cgbriggs99/InstrumentController/README.md

# InstrumentController
Controller for an instrument panel. Interfaces with MSFS.
