cgbriggs99/InstrumentController/circuits/x27_controller_proto/x27_controller.kicad_pcb

## KiCad design circuits/x27_controller_proto/x27_controller.kicad_pcb (2024-07-07)

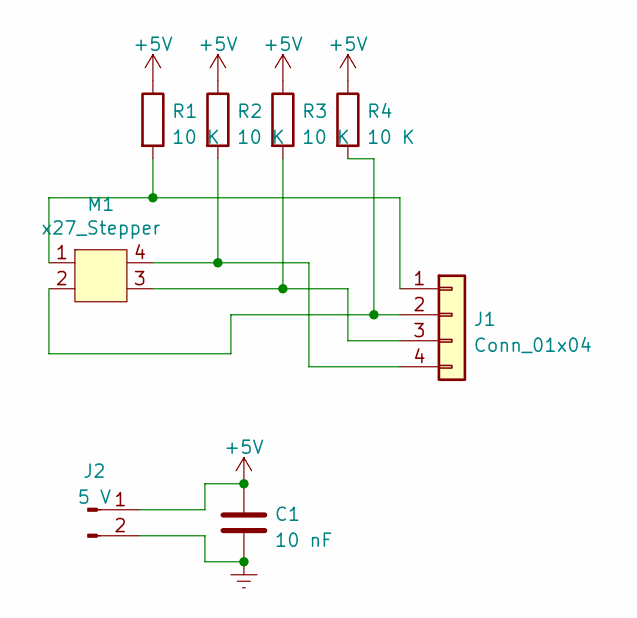
[picture p1: schematic x27_controller.kicad_sch]

Parts:
C1: 10 nF; C_0805_2012Metric_Pad1.18x1.45mm_HandSolder
J1: Conn_01x04; PinHeader_1x04_P2.54mm_Vertical
J2: 5 V; PinHeader_1x02_P2.54mm_Vertical
M1: x27_Stepper; Motor_x27-166
R1, R2, R3, R4: 10 K; R_0805_2012Metric_Pad1.20x1.40mm_HandSolder

Connections:
+5V: C1.1, J2.1, R1.1, R2.1, R3.1, R4.1
Earth: C1.2, J2.2
unnamed: J1.1, M1.1, R1.2
unnamed: J1.2, M1.2, R4.2
unnamed: J1.3, M1.3, R3.2
unnamed: J1.4, M1.4, R2.2

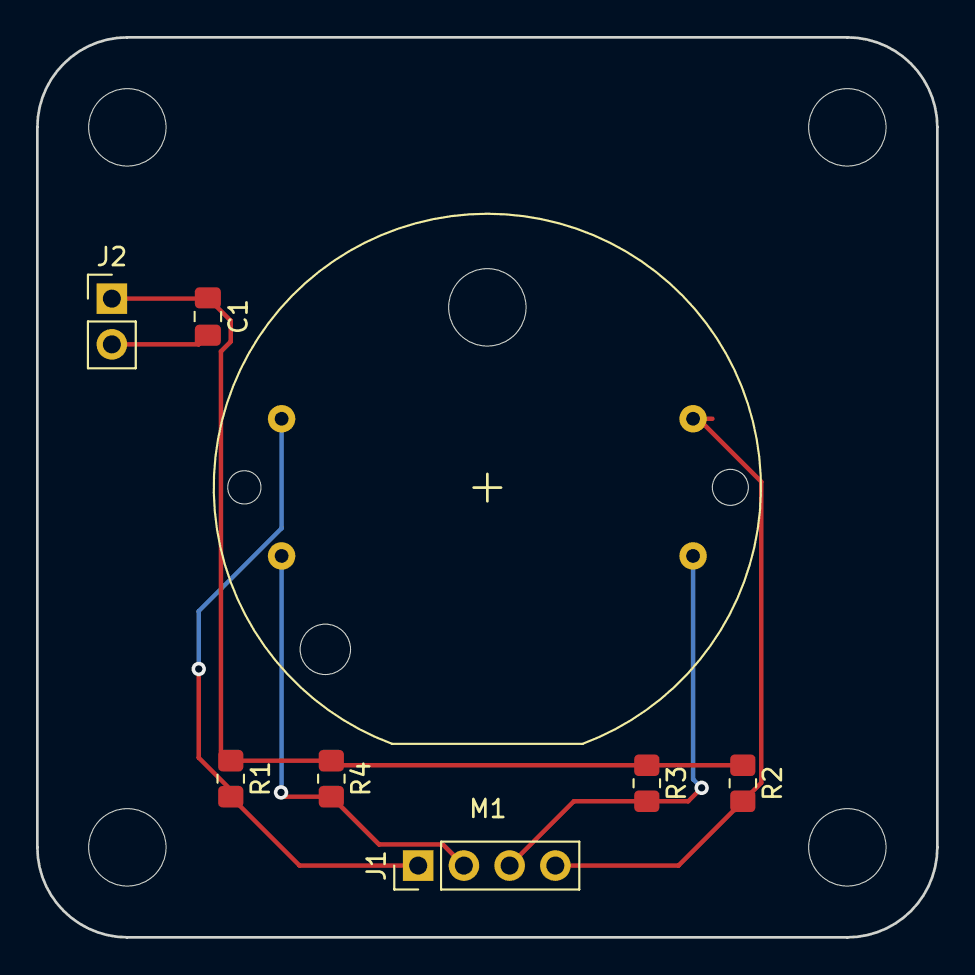
[picture p2: board circuits/x27_controller_proto/x27_controller.kicad_pcb from above]

Board: 2 copper layers, 50.0 x 50.0 mm, 8 parts (0 on the bottom side), 6 nets.
