cgbriggs99/InstrumentController/circuits/28byj_controller_proto/28byj_controller.kicad_pcb

## KiCad design circuits/28byj_controller_proto/28byj_controller.kicad_pcb (2024-07-07)

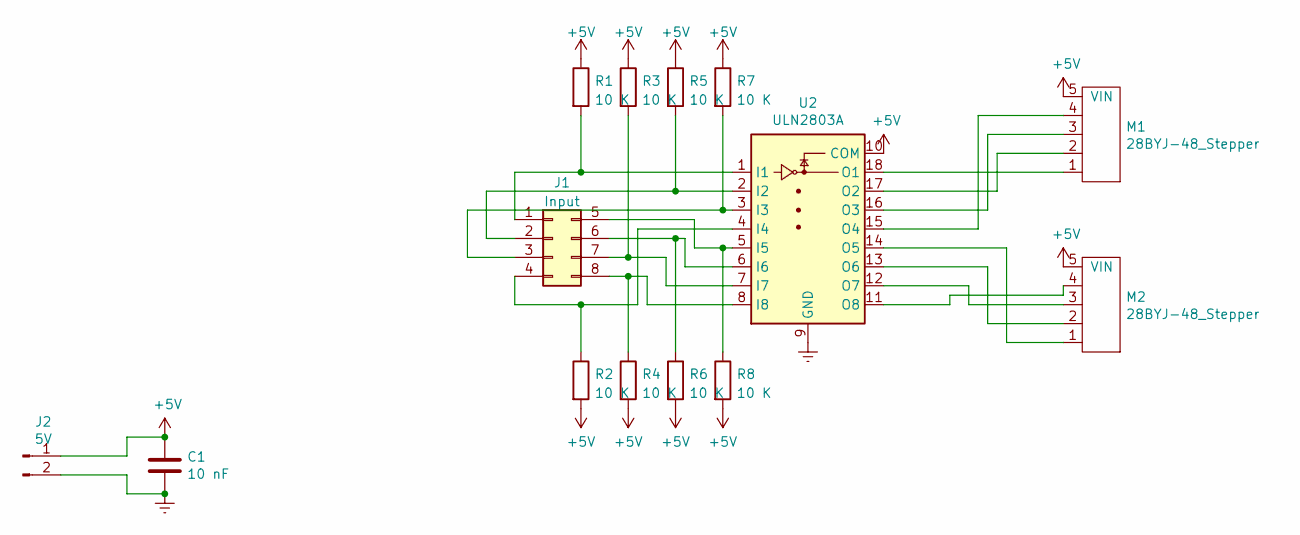
[picture p3: schematic 28byj_controller.kicad_sch]

Parts:
C1: 10 nF; C_0805_2012Metric_Pad1.18x1.45mm_HandSolder
J1: Input; PinHeader_2x04_P2.54mm_Vertical
J2: 5V; JST_XH_B2B-XH-AM_1x02_P2.50mm_Vertical
M1, M2: 28BYJ-48_Stepper; JST_XH_B5B-XH-A_1x05_P2.50mm_Vertical
R1, R2, R3, R4, R5, R6, R7, R8: 10 K; R_0805_2012Metric_Pad1.20x1.40mm_HandSolder
U2: ULN2803A; DIP-18_W7.62mm

Connections:
+5V: C1.1, J2.1, M1.5 (VIN), M2.5 (VIN), R1.1, R2.2, R3.1, R4.2, R5.1, R6.2, R7.1, R8.2, U2.10 (COM)
Earth: C1.2, J2.2, U2.9 (GND)
unnamed: J1.1, R1.2, U2.1 (I1)
unnamed: J1.2, R5.2, U2.2 (I2)
unnamed: J1.3, R7.2, U2.3 (I3)
unnamed: J1.4, R2.1, U2.4 (I4)
unnamed: J1.5, R8.1, U2.5 (I5)
unnamed: J1.6, R6.1, U2.6 (I6)
unnamed: J1.7, R3.2, U2.7 (I7)
unnamed: J1.8, R4.1, U2.8 (I8)
unnamed: M1.1, U2.18 (O1)
unnamed: M1.2, U2.17 (O2)
unnamed: M1.3, U2.16 (O3)
unnamed: M1.4, U2.15 (O4)
unnamed: M2.1, U2.14 (O5)
unnamed: M2.2, U2.13 (O6)
unnamed: M2.3, U2.12 (O7)
unnamed: M2.4, U2.11 (O8)

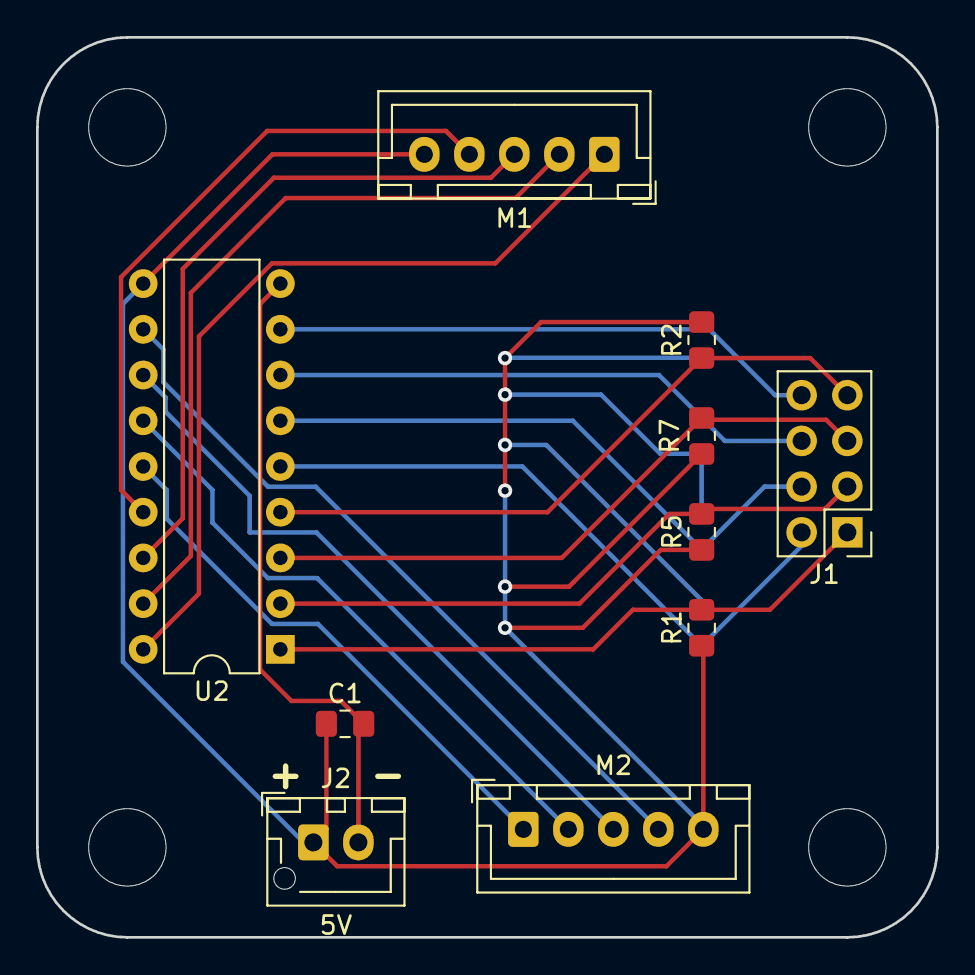
[picture p4: board 28byj_controller.kicad_pcb from above]

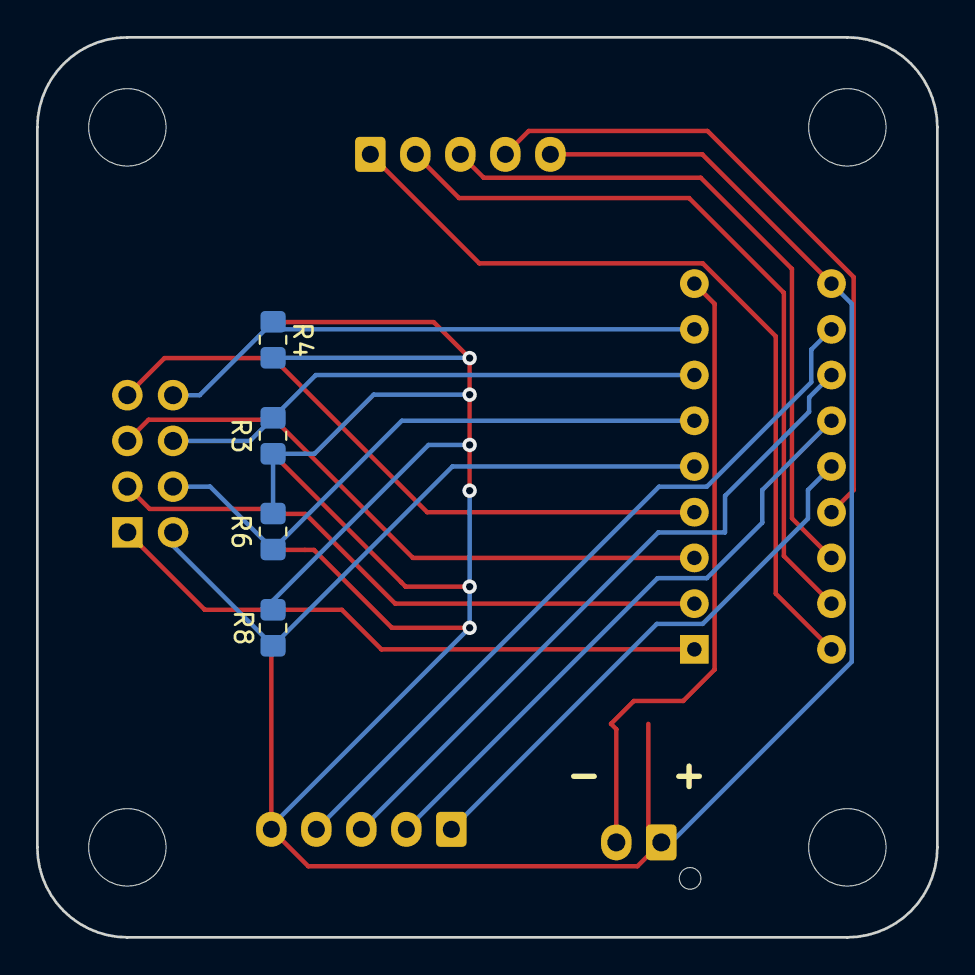
[picture p5: board 28byj_controller.kicad_pcb from below]

Board: 2 copper layers, 50.0 x 50.0 mm, 14 parts (4 on the bottom side), 18 nets.
