cgbriggs99/InstrumentController/circuits/base_controller/base_controller.kicad_pcb

## KiCad design circuits/base_controller/base_controller.kicad_pcb (2024-06-12)

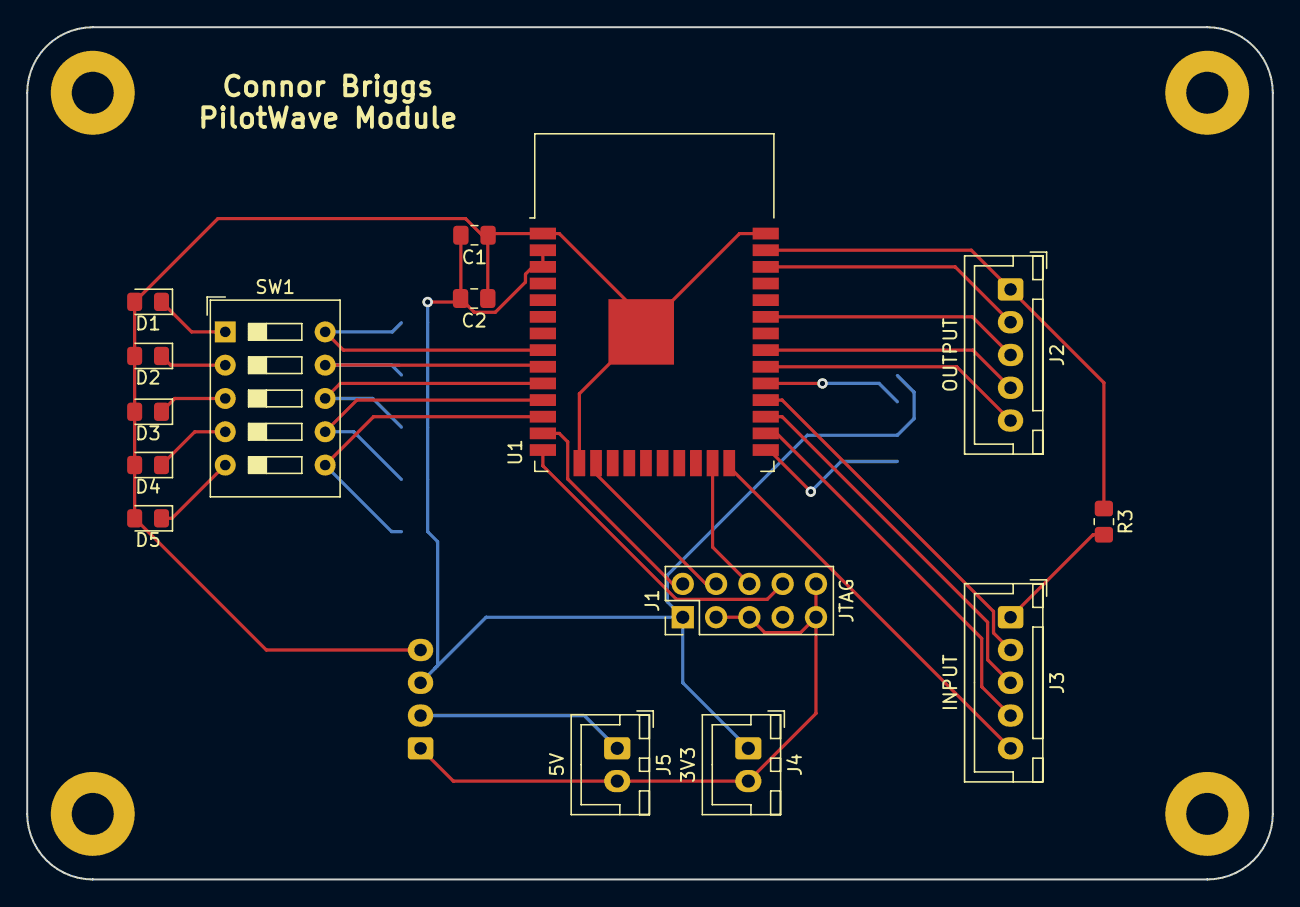
[picture p6: board circuits/base_controller/base_controller.kicad_pcb from above]

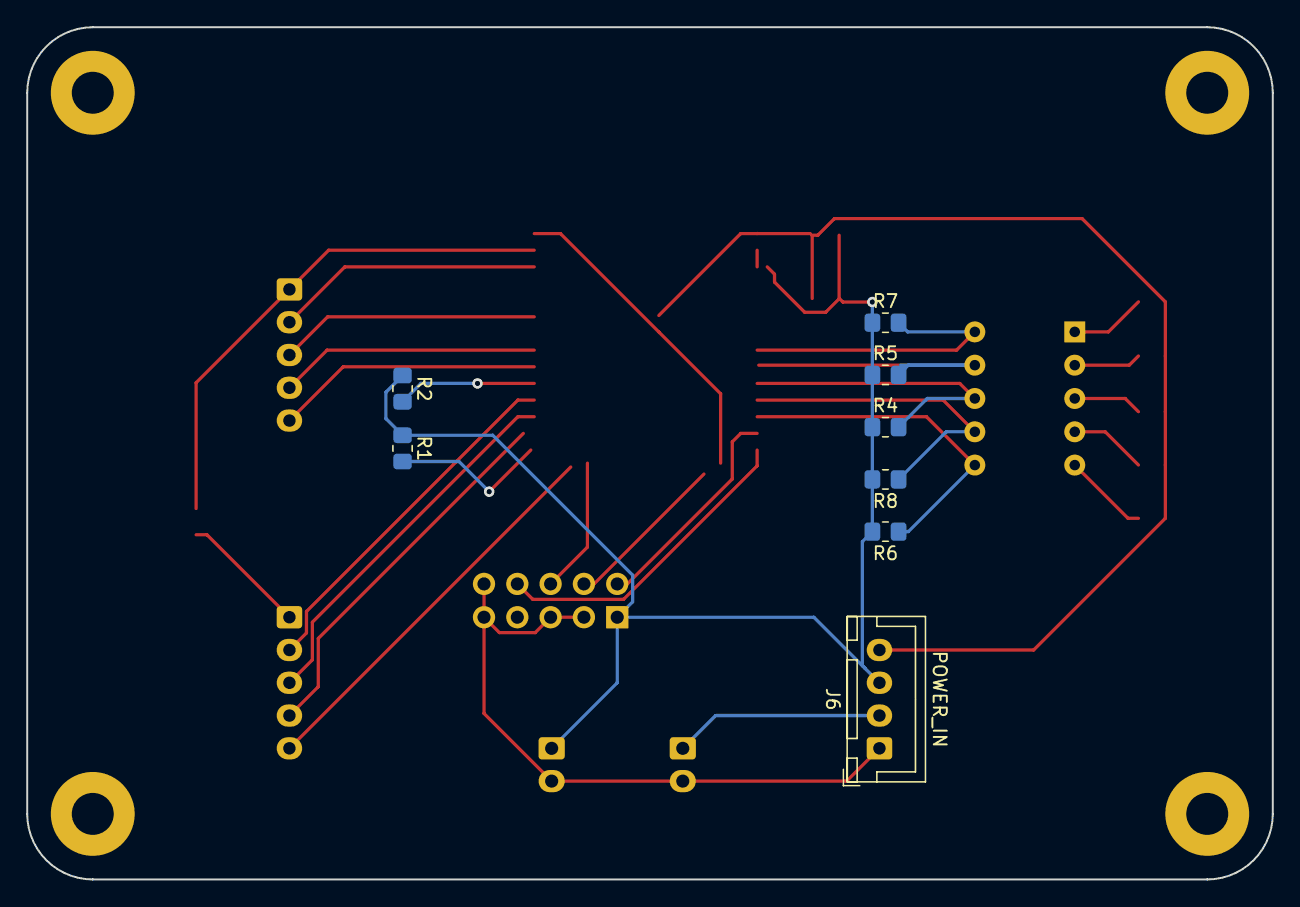
[picture p7: board circuits/base_controller/base_controller.kicad_pcb from below]

Board: 2 copper layers, 95.0 x 65.0 mm, 23 parts (8 on the bottom side), 29 nets.

Parts:
C1: 10 uF; C_0805_2012Metric_Pad1.18x1.45mm_HandSolder
C2: 0.1 uF; C_0805_2012Metric_Pad1.18x1.45mm_HandSolder
D1, D2, D3, D4, D5: DIODE; D_0805_2012Metric_Pad1.15x1.40mm_HandSolder
J1: JTAG; PinHeader_2x05_P2.54mm_Vertical
J2: OUTPUT; JST_XH_B5B-XH-A_1x05_P2.50mm_Vertical
J3: INPUT; JST_XH_B5B-XH-A_1x05_P2.50mm_Vertical
J4: 3V3; JST_XH_B2B-XH-A_1x02_P2.50mm_Vertical
J5: 5V; JST_XH_B2B-XH-A_1x02_P2.50mm_Vertical
J6: POWER_IN; JST_XH_B4B-XH-A_1x04_P2.50mm_Vertical
R1, R2: 10 K; R_0805_2012Metric_Pad1.20x1.40mm_HandSolder
R3: 1 K; R_0805_2012Metric_Pad1.20x1.40mm_HandSolder
R4, R5, R6, R7, R8: 4.7 k; R_0805_2012Metric_Pad1.20x1.40mm_HandSolder
SW1: DEV_CLASS; SW_DIP_SPSTx05_Slide_9.78x14.88mm_W7.62mm_P2.54mm
U1: ESP32-WROOM-32

Connections:
+5V: J5.1 (5V), J6.2
DATA_IO: J2.1, R3.1, U1.37 (IO23)
DEVCL_0: R7.2, SW1.10, U1.8 (IO32)
DEVCL_1: R5.2, SW1.9, U1.9 (IO33)
DEVCL_2: R4.2, SW1.8, U1.10 (IO25)
DEVCL_3: R8.1, SW1.7, U1.11 (IO26)
DEVCL_4: R6.1, SW1.6, U1.12 (IO27)
EN: C1.2, C2.2, J1.1 (VTref), J4.1 (3V3), J6.3, R1.1, R2.1, R4.1, R5.1, R6.2, R7.1, R8.2, U1.2 (VDD), U1.3 (EN)
Earth: C1.1, C2.1, D1.2 (A), D2.2 (A), D3.2 (A), D4.2 (A), D5.2 (A), J1.3 (GND), J1.5 (GND), J1.9 (GNDDetect), J1.10 (~RESET), J4.2 (GND), J5.2 (GND), J6.1, J6.4, U1.1 (GND), U1.15 (GND), U1.38 (GND), U1.39 (GND)
IO0: R1.2, U1.25 (IO0)
IO5: R2.2, U1.29 (IO5)
MR_1: J2.5, U1.30 (IO18)
MR_2: J3.5, U1.24 (IO2)
MTCK: J1.4 (SWDCLK/TCK), U1.16 (IO13)
MTDI: J1.8 (NC/TDI), U1.14 (IO12)
MTDO: J1.6 (SWO/TDO), U1.23 (IO15)
MTMS: J1.2 (SWDIO/TMS), U1.13 (IO14)
unnamed: D1.1 (K), SW1.1
unnamed: D2.1 (K), SW1.2
unnamed: D3.1 (K), SW1.3
unnamed: D4.1 (K), SW1.4
unnamed: D5.1 (K), SW1.5
unnamed: J3.1, R3.2
OE_1: J2.4, U1.31 (IO19)
PL_2: J3.4, U1.26 (IO4)
SHCP_1: J2.2, U1.36 (IO22)
SHCP_2: J3.2, U1.28 (IO17)
STCP_1: J2.3, U1.33 (IO21)
STCP_2: J3.3, U1.27 (IO16)
