cgbriggs99/InstrumentController/circuits/base_controller_proto/base_controller.kicad_pcb

## KiCad design circuits/base_controller_proto/base_controller.kicad_pcb (2023-12-29)

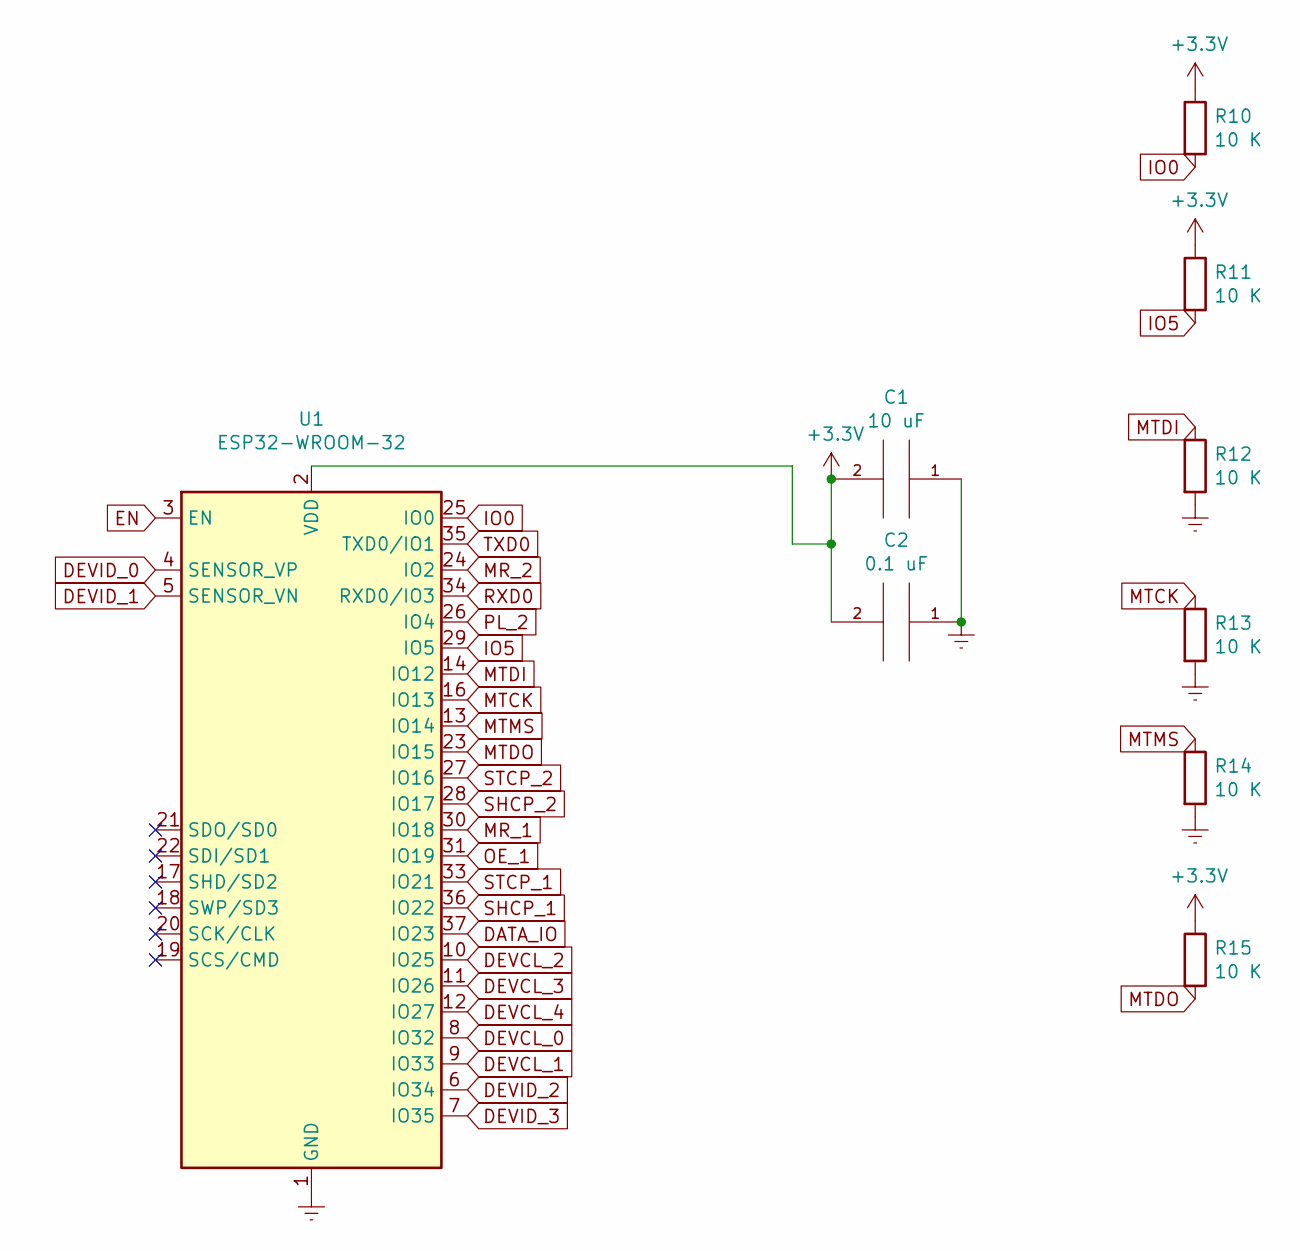
[picture p8: schematic ESP32.kicad_sch]

Parts:
C1: 10 uF; C_0805_2012Metric_Pad1.18x1.45mm_HandSolder
C2: 0.1 uF; C_0805_2012Metric_Pad1.18x1.45mm_HandSolder
R10, R11, R12, R13, R14, R15: 10 K; R_0805_2012Metric_Pad1.20x1.40mm_HandSolder
U1: ESP32-WROOM-32

Connections:
+3V3: C1.2, C2.2, R10.1, R11.1, R15.1, U1.2 (VDD); also elsewhere on the board
DATA_IO: U1.37 (IO23); also elsewhere on the board
DEVCL_0: U1.8 (IO32); also elsewhere on the board
DEVCL_1: U1.9 (IO33); also elsewhere on the board
DEVCL_2: U1.10 (IO25); also elsewhere on the board
DEVCL_3: U1.11 (IO26); also elsewhere on the board
DEVCL_4: U1.12 (IO27); also elsewhere on the board
DEVID_0: U1.4 (SENSOR_VP); also elsewhere on the board
DEVID_1: U1.5 (SENSOR_VN); also elsewhere on the board
DEVID_2: U1.6 (IO34); also elsewhere on the board
DEVID_3: U1.7 (IO35); also elsewhere on the board
EN: U1.3 (EN); also elsewhere on the board
Earth: C1.1, C2.1, R12.2, R13.2, R14.2, U1.1 (GND), U1.15 (GND), U1.38 (GND), U1.39 (GND); also elsewhere on the board
IO0: R10.2, U1.25 (IO0)
IO5: R11.2, U1.29 (IO5)
MR_1: U1.30 (IO18); also elsewhere on the board
MR_2: U1.24 (IO2); also elsewhere on the board
MTCK: R13.1, U1.16 (IO13)
MTDI: R12.1, U1.14 (IO12)
MTDO: R15.2, U1.23 (IO15)
MTMS: R14.1, U1.13 (IO14)
OE_1: U1.31 (IO19); also elsewhere on the board
PL_2: U1.26 (IO4); also elsewhere on the board
RXD0: U1.34 (RXD0/IO3); also elsewhere on the board
SHCP_1: U1.36 (IO22); also elsewhere on the board
SHCP_2: U1.28 (IO17); also elsewhere on the board
STCP_1: U1.33 (IO21); also elsewhere on the board
STCP_2: U1.27 (IO16); also elsewhere on the board
TXD0: U1.35 (TXD0/IO1); also elsewhere on the board

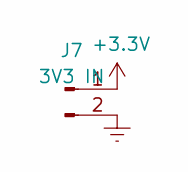
[picture p9: schematic 3V3_Supply.kicad_sch]

Parts:
J7: 3V3 IN; PinHeader_1x02_P2.54mm_Vertical

Connections:
+3V3: J7.1; also elsewhere on the board
Earth: J7.2; also elsewhere on the board

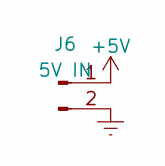
[picture p10: schematic 5V_Supply.kicad_sch]

Parts:
J6: 5V IN; PinHeader_1x02_P2.54mm_Vertical

Connections:
+5V: J6.1; also elsewhere on the board
Earth: J6.2; also elsewhere on the board

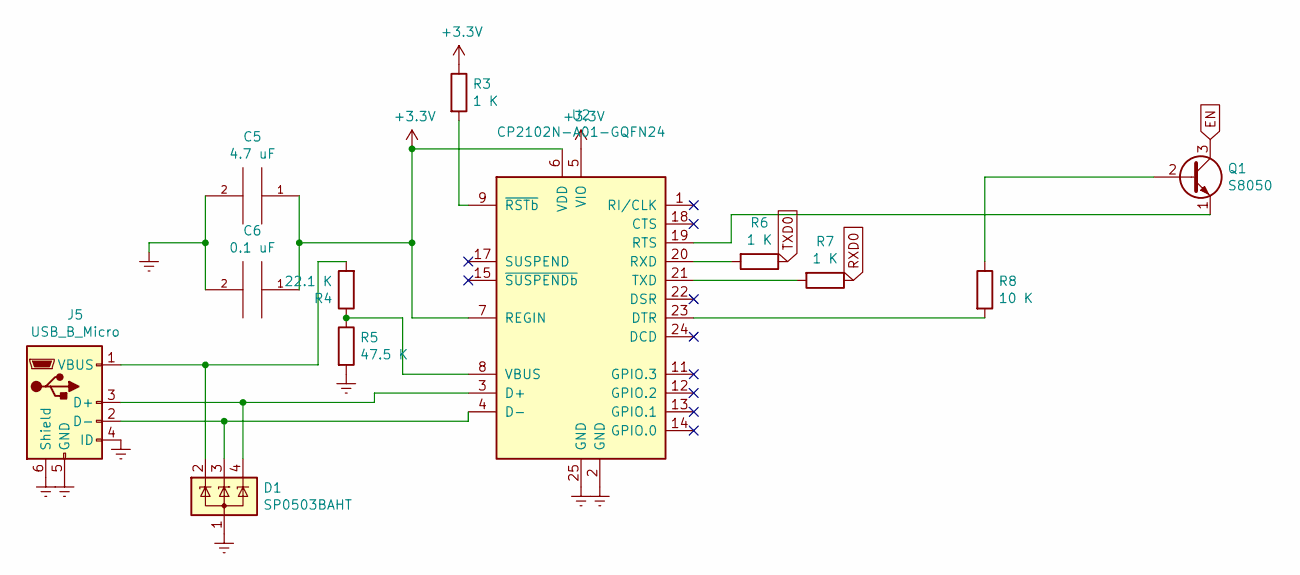
[picture p11: schematic USB_Programmer.kicad_sch]

Parts:
C5: 4.7 uF; C_0805_2012Metric_Pad1.18x1.45mm_HandSolder
C6: 0.1 uF; C_0805_2012Metric_Pad1.18x1.45mm_HandSolder
D1: SP0503BAHT; SOT-143
J5: USB_B_Micro; USB_Micro-B_Amphenol_10118194_Horizontal
Q1: S8050; SOT-23
R3, R6, R7: 1 K; R_0805_2012Metric_Pad1.20x1.40mm_HandSolder
R4: 22.1 K; R_0805_2012Metric_Pad1.20x1.40mm_HandSolder
R5: 47.5 K; R_0805_2012Metric_Pad1.20x1.40mm_HandSolder
R8: 10 K; R_0805_2012Metric_Pad1.20x1.40mm_HandSolder
U2: CP2102N-A01-GQFN24; QFN-24-1EP_4x4mm_P0.5mm_EP2.6x2.6mm

Connections:
+3V3: C5.1, C6.1, R3.1, U2.5 (VIO), U2.6 (VDD), U2.7 (REGIN); also elsewhere on the board
EN: Q1.3 (C); also elsewhere on the board
Earth: C5.2, C6.2, D1.1 (A), J5.4 (ID), J5.5 (GND), J5.6 (Shield), R5.2, U2.2 (GND), U2.25 (GND); also elsewhere on the board
unnamed: D1.2 (K), J5.1 (VBUS), R4.2
unnamed: D1.3 (K), J5.2 (D-), U2.4 (D-)
unnamed: D1.4 (K), J5.3 (D+), U2.3 (D+)
unnamed: Q1.1 (E), U2.19 (RTS)
unnamed: Q1.2 (B), R8.1
unnamed: R3.2, U2.9 (~RSTb)
unnamed: R4.1, R5.1, U2.8 (VBUS)
unnamed: R6.2, U2.20 (RXD)
unnamed: R7.2, U2.21 (TXD)
unnamed: R8.2, U2.23 (DTR)
RXD0: R7.1; also elsewhere on the board
TXD0: R6.1; also elsewhere on the board

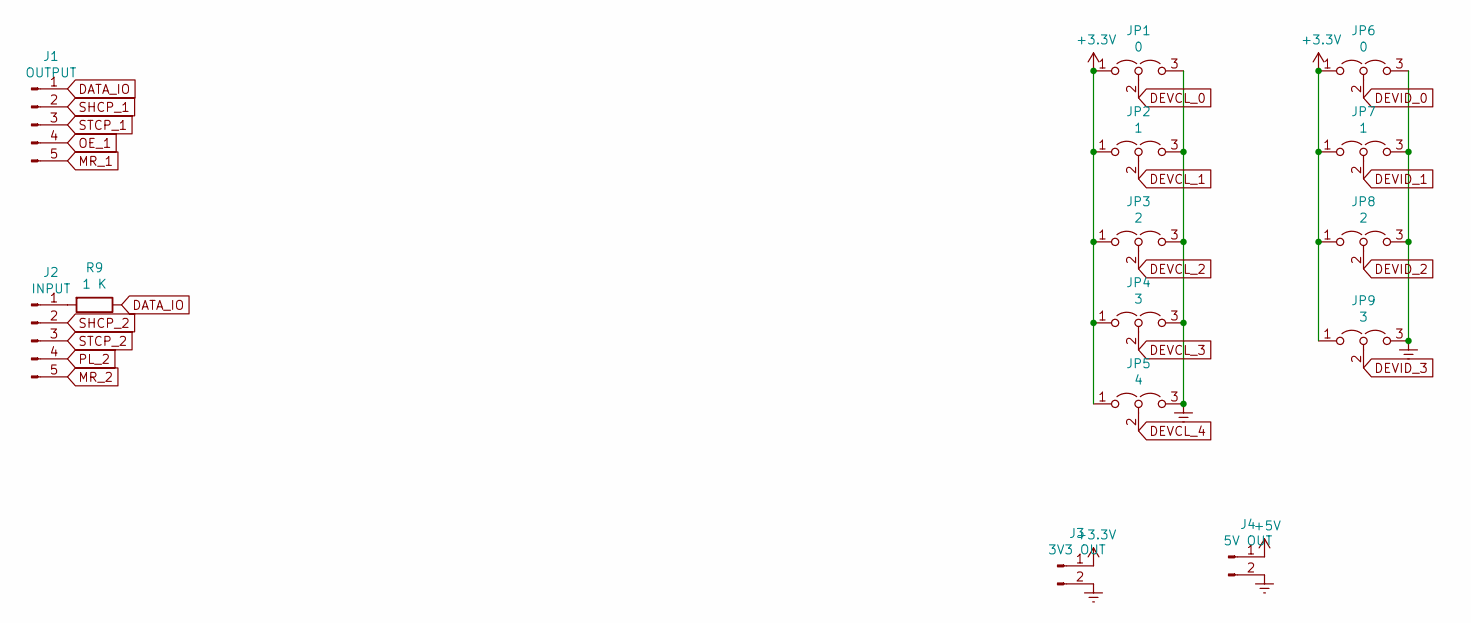
[picture p12: schematic Headers.kicad_sch]

Parts:
J1: OUTPUT; JST_XH_B5B-XH-A_1x05_P2.50mm_Vertical
J2: INPUT; JST_XH_B5B-XH-A_1x05_P2.50mm_Vertical
J3: 3V3 OUT; PinHeader_1x02_P2.54mm_Vertical
J4: 5V OUT; PinHeader_1x02_P2.54mm_Vertical
JP1, JP6: 0; PinHeader_1x03_P2.54mm_Vertical
JP2, JP7: 1; PinHeader_1x03_P2.54mm_Vertical
JP3, JP8: 2; PinHeader_1x03_P2.54mm_Vertical
JP4, JP9: 3; PinHeader_1x03_P2.54mm_Vertical
JP5: 4; PinHeader_1x03_P2.54mm_Vertical
R9: 1 K; R_0805_2012Metric_Pad1.20x1.40mm_HandSolder

Connections:
+3V3: J3.1, JP1.1 (A), JP2.1 (A), JP3.1 (A), JP4.1 (A), JP5.1 (A), JP6.1 (A), JP7.1 (A), JP8.1 (A), JP9.1 (A); also elsewhere on the board
+5V: J4.1; also elsewhere on the board
DATA_IO: J1.1, R9.1; also elsewhere on the board
DEVCL_0: JP1.2 (C); also elsewhere on the board
DEVCL_1: JP2.2 (C); also elsewhere on the board
DEVCL_2: JP3.2 (C); also elsewhere on the board
DEVCL_3: JP4.2 (C); also elsewhere on the board
DEVCL_4: JP5.2 (C); also elsewhere on the board
DEVID_0: JP6.2 (C); also elsewhere on the board
DEVID_1: JP7.2 (C); also elsewhere on the board
DEVID_2: JP8.2 (C); also elsewhere on the board
DEVID_3: JP9.2 (C); also elsewhere on the board
Earth: J3.2, J4.2, JP1.3 (B), JP2.3 (B), JP3.3 (B), JP4.3 (B), JP5.3 (B), JP6.3 (B), JP7.3 (B), JP8.3 (B), JP9.3 (B); also elsewhere on the board
MR_1: J1.5; also elsewhere on the board
MR_2: J2.5; also elsewhere on the board
unnamed: J2.1, R9.2
OE_1: J1.4; also elsewhere on the board
PL_2: J2.4; also elsewhere on the board
SHCP_1: J1.2; also elsewhere on the board
SHCP_2: J2.2; also elsewhere on the board
STCP_1: J1.3; also elsewhere on the board
STCP_2: J2.3; also elsewhere on the board

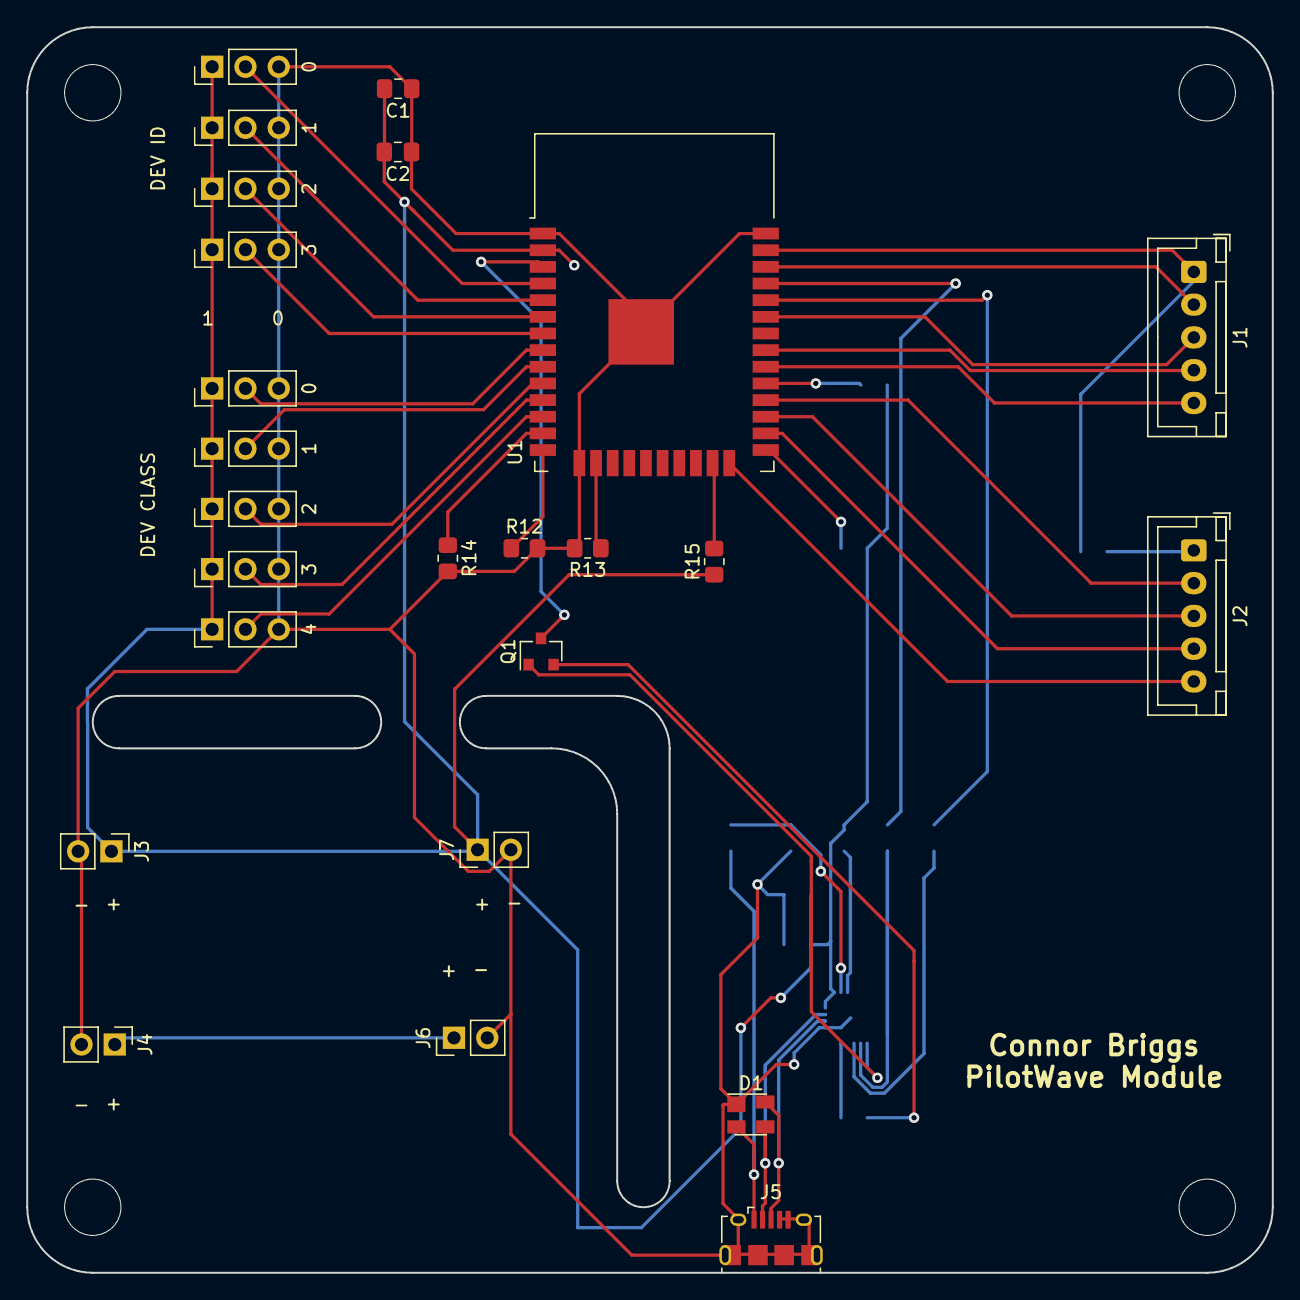
[picture p13: board circuits/base_controller_proto/base_controller.kicad_pcb from above]

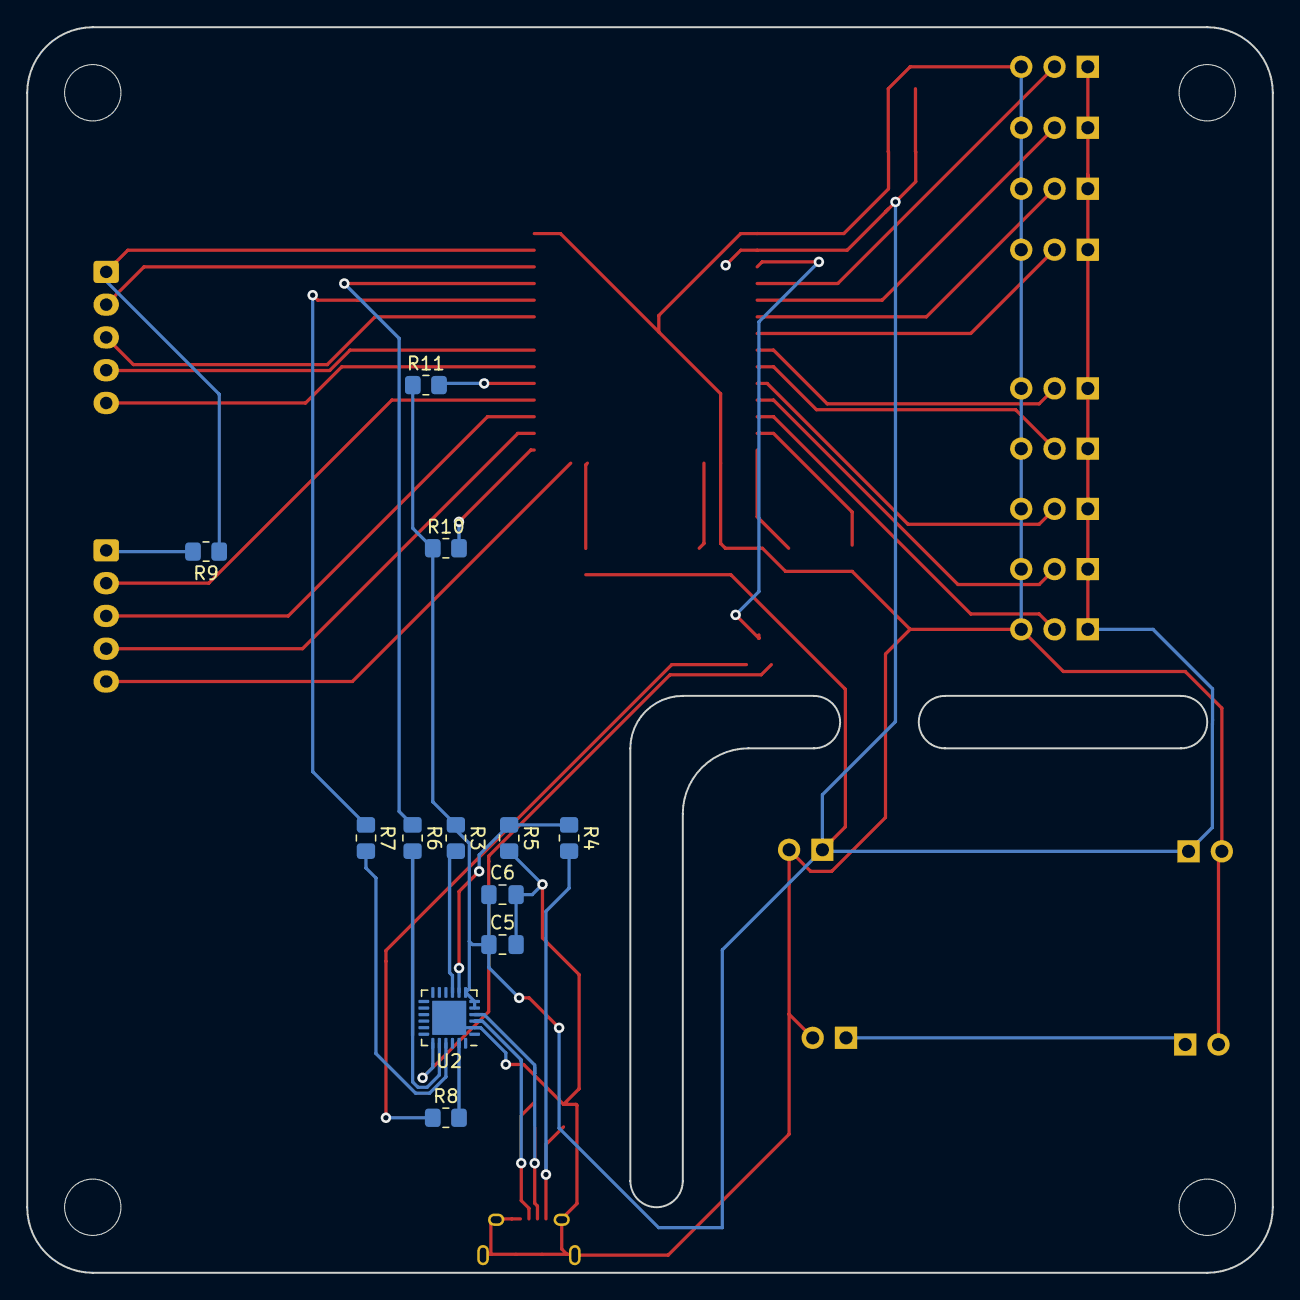
[picture p14: board circuits/base_controller_proto/base_controller.kicad_pcb from below]

Board: 2 copper layers, 95.0 x 95.0 mm, 37 parts (12 on the bottom side), 41 nets.
