cgbriggs99/InstrumentController/circuits/x27_controller/x27_controller.kicad_pcb

## KiCad design circuits/x27_controller/x27_controller.kicad_pcb (2023-12-29)

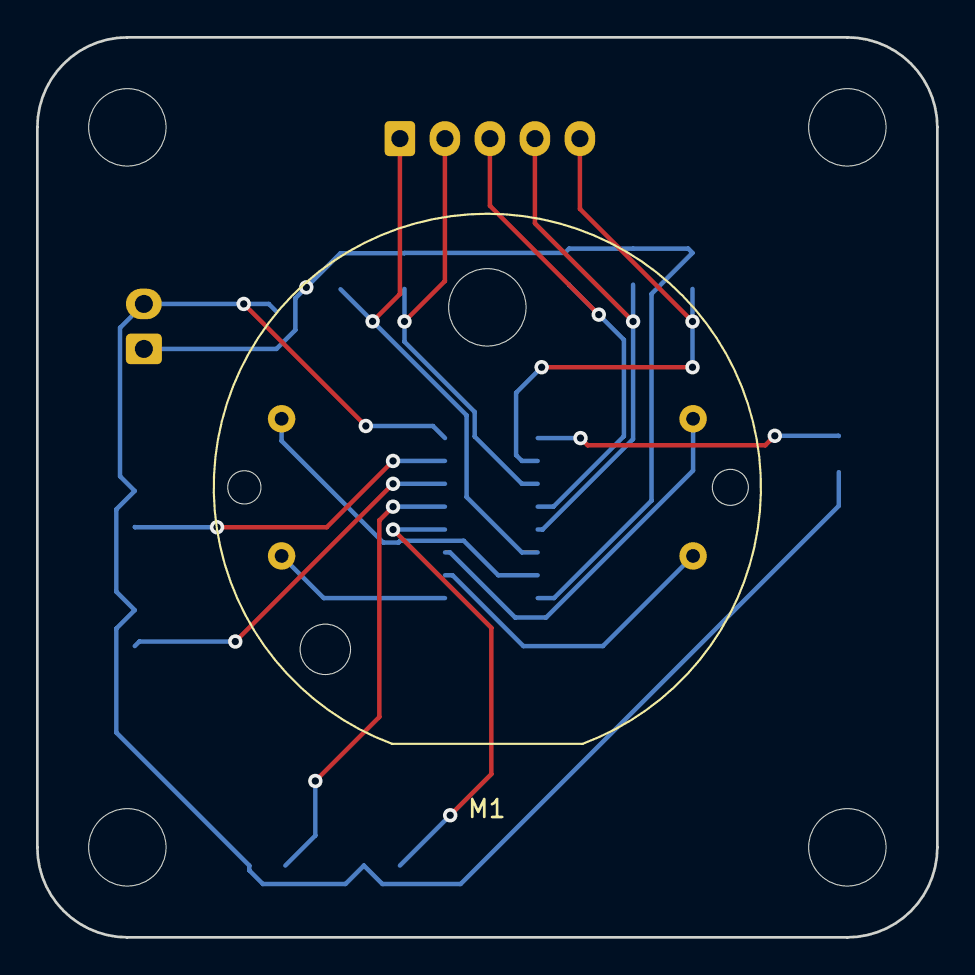
[picture p15: board circuits/x27_controller/x27_controller.kicad_pcb from above]

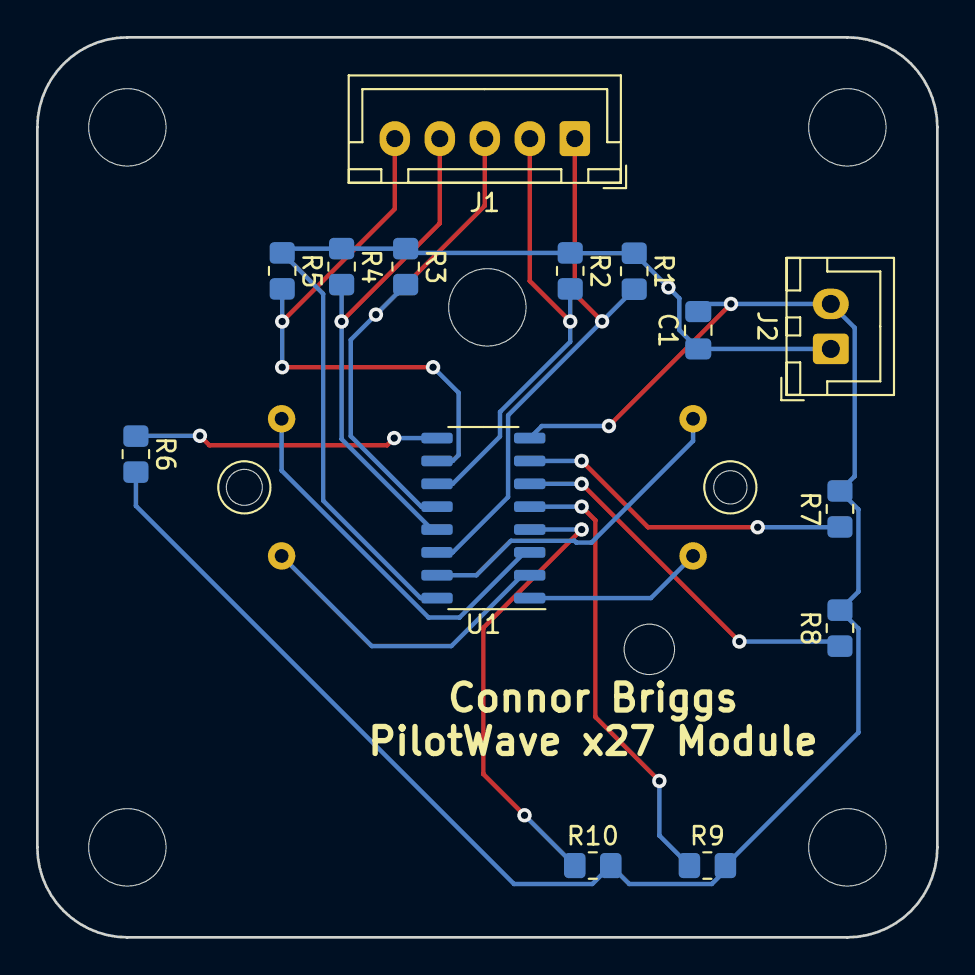
[picture p16: board circuits/x27_controller/x27_controller.kicad_pcb from below]

Board: 2 copper layers, 50.0 x 50.0 mm, 15 parts (14 on the bottom side), 16 nets.

Parts:
C1: 10 nF; C_0805_2012Metric_Pad1.18x1.45mm_HandSolder
J1: INPUT; JST_XH_B5B-XH-A_1x05_P2.50mm_Vertical
J2: 5V; JST_XH_B2B-XH-A_1x02_P2.50mm_Vertical
M1: x27_Stepper; Motor_x27-166
R1, R2, R3, R4, R5: 10K; R_0805_2012Metric_Pad1.20x1.40mm_HandSolder
R6, R7, R8, R9, R10: 1K; R_0805_2012Metric_Pad1.20x1.40mm_HandSolder
U1: 74HC595; SO-16_3.9x9.9mm_P1.27mm

Connections:
+5V: C1.1, J2.1, R1.1, R2.1, R3.1, R4.1, R5.1, U1.16
Earth: C1.2, J2.2, R6.2, R7.2, R8.2, R9.2, R10.2, U1.8
unnamed: J1.1, R1.2, U1.14
unnamed: J1.2, R2.2, U1.11
unnamed: J1.3, R3.2, U1.12
unnamed: J1.4, R4.2, U1.13
unnamed: J1.5, R5.2, U1.10
unnamed: M1.1, U1.15
unnamed: M1.2, U1.1
unnamed: M1.3, U1.2
unnamed: M1.4, U1.3
unnamed: R6.1, U1.9
unnamed: R7.1, U1.7
unnamed: R8.1, U1.6
unnamed: R9.1, U1.5
unnamed: R10.1, U1.4
