cgbriggs99/InstrumentController/device-src/main/topics.cpp

#include "topics.hpp"

// Constant topics.
const char *will_topic = "/top/errors";
const char *dev_info_topic = "/top/dev_info";
const char *test_x27_topic = "/top/test_x27";
const char *test_28byj_topic = "/top/test_28byj";
const char *test_7s_topic = "/top/test_7s"; 
const char *altimeter_topic = "/top/altimeter";
const char *spedometer_topic = "/top/spedometer";
const char *tachometer_topic = "/top/tachometer";
const char *clock_topic = "/top/clock";
const char *fuel_gauge_topic = "/top/fuel";
const char *oil_gauge_topic = "/top/oil";
const char *radio_output_topic = "/top/radio/display";
const char *radio_input_topic = "/top/radio/interface";
const char *engine_starter_topic = "/top/starter";
const char *debug_topic = "/top/debug";
