cgbriggs99/InstrumentController/(commit log)

2023-08-04 Added circuits for the central controller.
    [3V3_Supply.sch, 5V_Supply.sch, ESP32.sch, Headers.sch, USB_Programmer.sch, base_controller.kicad_pcb, base_controller.sch, radio_controller.kicad_pcb]
2023-08-04 Small edit
    [USB_Programmer.sch, base_controller.kicad_pcb]
2023-08-05 Made break-out boards for the motors
    [28byj_controller.kicad_pcb, 28byj_controller.sch, 5V_Supply.sch, Headers.sch, USB_Programmer.sch, base_controller.kicad_pcb, x27_controller.kicad_pcb, x27_controller.sch]
2023-08-16 Added some drivers
2023-12-29 Big changes
    [28byj_controller-B_Cu.gbr, 28byj_controller-B_Mask.gbr, 28byj_controller-B_Paste.gbr, 28byj_controller-B_Silkscreen.gbr, 28byj_controller-Edge_Cuts.gbr, 28byj_controller-F_Cu.gbr, 28byj_controller-F_Mask.gbr, 28byj_controller-F_Paste.gbr]
2023-12-31 Code works
    [base_controller.sch]
2024-01-01 Device uses mac address as id
2024-06-12 Big updates
    [3V3_Supply.kicad_sch, 5V_Supply.kicad_sch, ESP32.kicad_sch, Headers.kicad_sch, USB_Programmer.kicad_sch, atx-power.kicad_pcb, atx-power.kicad_sch, base_controller.kicad_pcb]
2024-06-15 Fixed a few bugs
    [device_info.hpp, main.ino, topics.cpp, topics.hpp]
2024-07-02 Code works and is tested on waveforms.
    [28byj_controller.kicad_pcb, 28byj_controller.kicad_sch, x27_controller.kicad_pcb, x27_controller.kicad_sch]
2024-07-07 Modified some circuits.
    [28byj_controller.kicad_pcb, 28byj_controller.kicad_sch]
2024-07-07 Added more pullups
    [x27_controller.kicad_pcb, x27_controller.kicad_sch]
